aesirkth/Sigurd/Hardware/Sensor.kicad_pcb

## KiCad design Hardware/Sensor.kicad_pcb (2025-11-24)

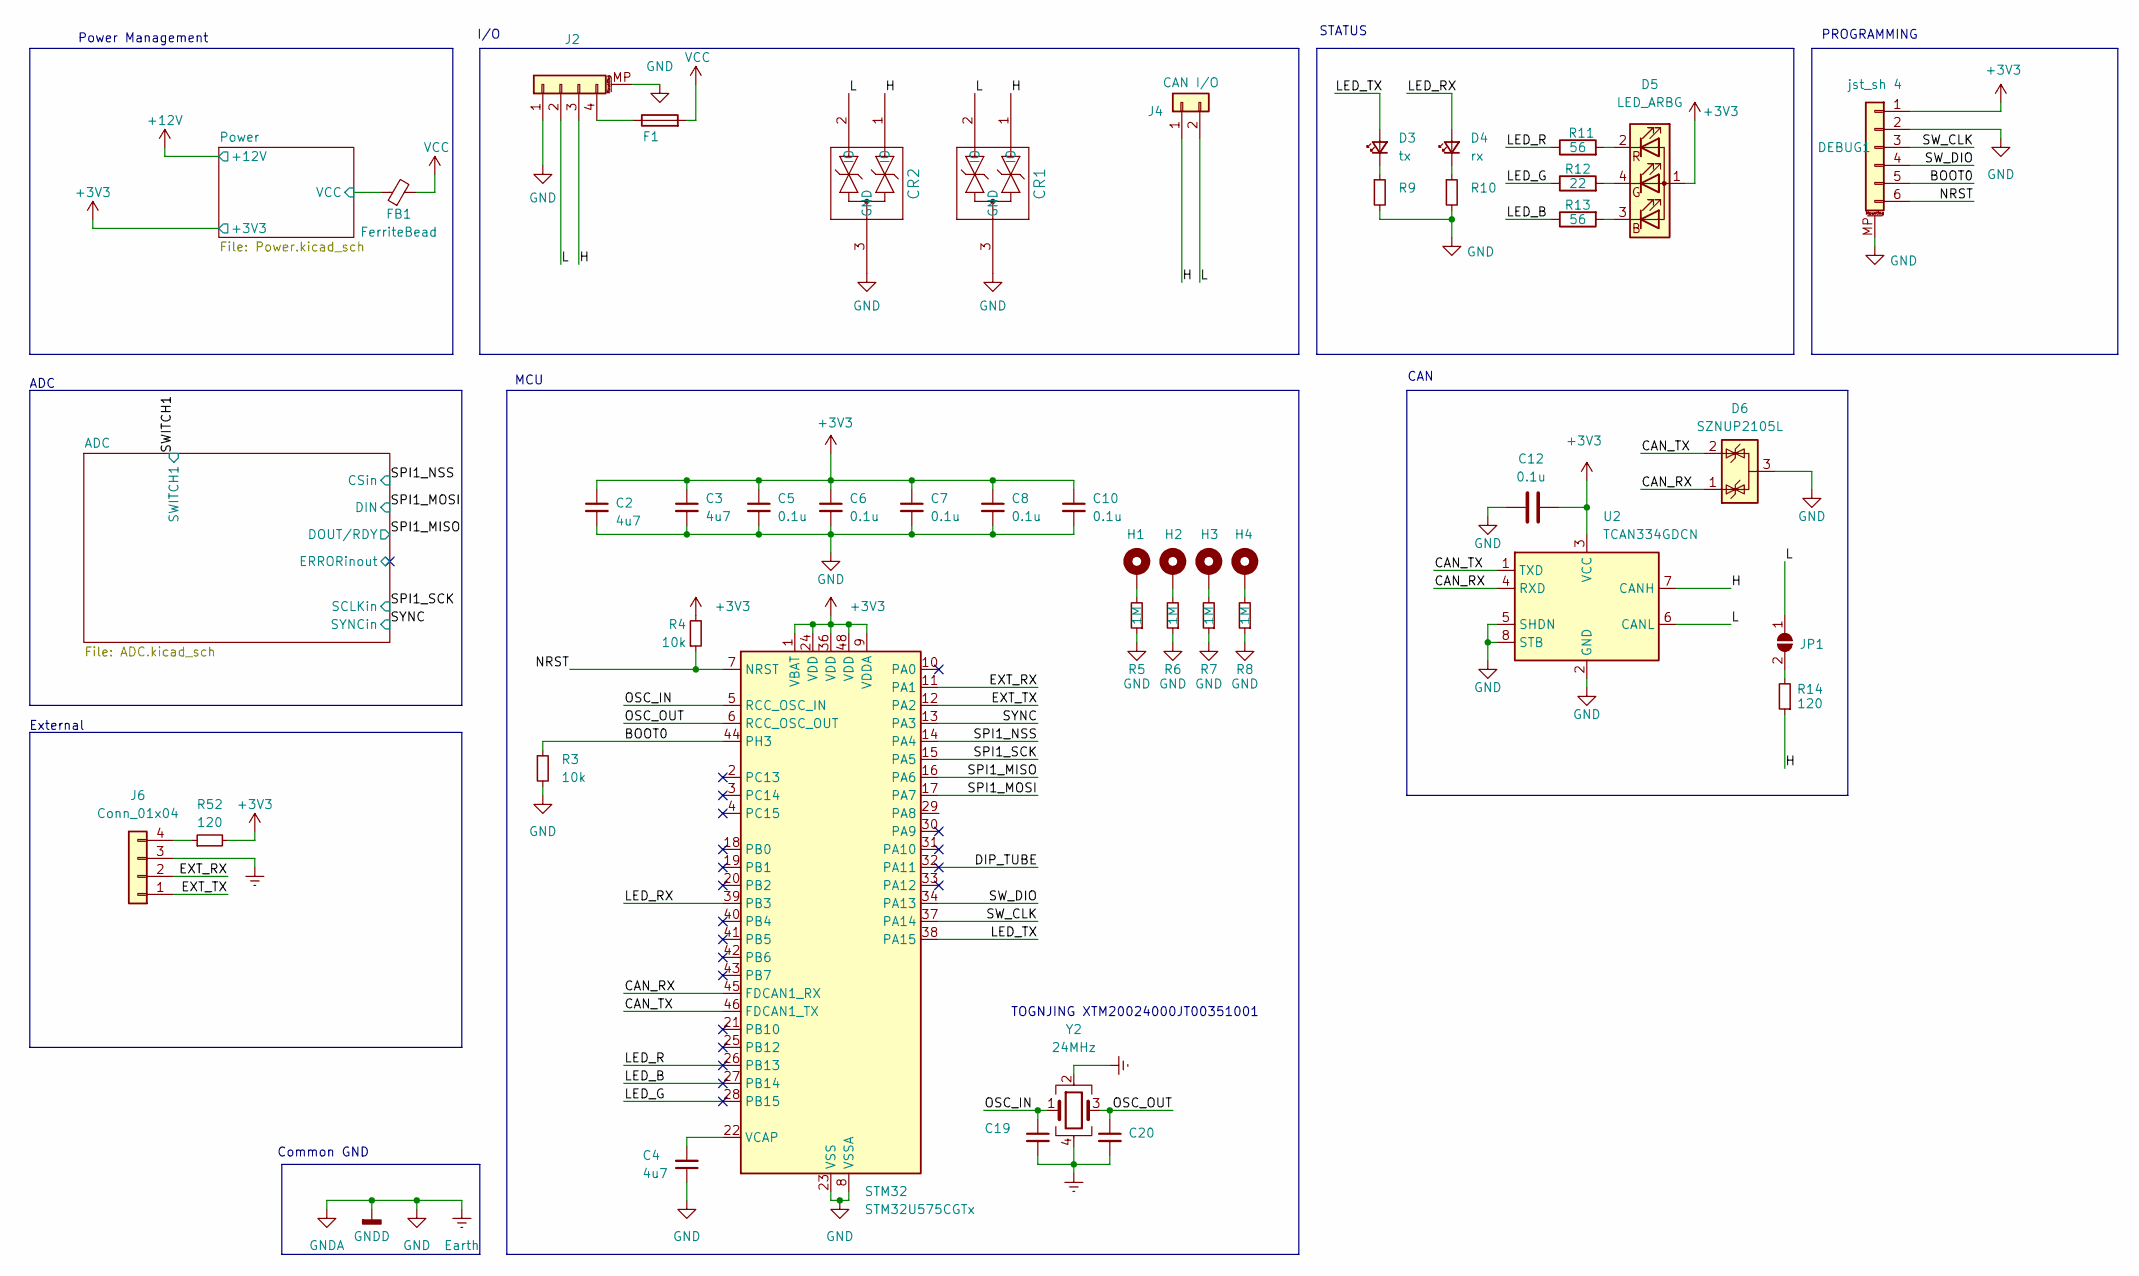
[picture p1: schematic Sensor.kicad_sch]

Parts:
C2, C3, C4: 4u7; C_0402_1005Metric
C5, C6, C7, C8, C10, C12: 0.1u; C_0402_1005Metric
C19, C20: 18p; C_0402_1005Metric
CR1, CR2: ESD2CAN36DBZRQ1; SOT-23-3
D3: tx; LED_0603_1608Metric_Pad1.05x0.95mm_HandSolder
D4: rx; LED_0603_1608Metric_Pad1.05x0.95mm_HandSolder
D5: LED_ARBG; LED_Lumex_SML-LX0404SIUPGUSB
D6: SZNUP2105L; SOT-23
DEBUG1: jst_sh 4; JST_SH_SM06B-SRSS-TB_1x06-1MP_P1.00mm_Horizontal
F1: Fuse_1206_3216Metric
FB1: FerriteBead; L_0603_1608Metric
H1, H2, H3, H4: MountingHole_Pad; MountingHole_3.2mm_M3_Pad_Via
J2: Conn_01x04_MountingPin; JST_GH_BM04B-GHS-TBT_1x04-1MP_P1.25mm_Vertical
J4: CAN I/O; JST_XH_B2B-XH-A_1x02_P2.50mm_Vertical
J6: Conn_01x04; PinSocket_1x04_P1.27mm_Vertical
JP1: SolderJumper_2_Open; SolderJumper-2_P1.3mm_Open_TrianglePad1.0x1.5mm
R3, R4: 10k; R_0402_1005Metric
R5, R6, R7, R8: 1M; R_0603_1608Metric_Pad0.98x0.95mm_HandSolder
R9, R10: 330; R_0603_1608Metric_Pad0.98x0.95mm_HandSolder
R11, R13: 56; R_0603_1608Metric_Pad0.98x0.95mm_HandSolder
R12: 22; R_0603_1608Metric_Pad0.98x0.95mm_HandSolder
R14: 120; R_0603_1608Metric_Pad0.98x0.95mm_HandSolder
R52: 120; R_0402_1005Metric
STM32: STM32U575CGTx; LQFP-48_7x7mm_P0.5mm
U2: TCAN334GDCN; TSOT-23-8
Y2: 24MHz; Crystal_SMD_2016-4Pin_2.0x1.6mm

Connections:
+3V3: C2.1, C3.1, C5.1, C6.1, C7.1, C8.1, C10.1, C12.2, D5.1 (A), DEBUG1.1, R4.2, R52.2, STM32.1 (VBAT), STM32.9 (VDDA), STM32.24 (VDD), STM32.36 (VDD), STM32.48 (VDD), U2.3 (VCC); also elsewhere on the board
+12V: FB1.1; also elsewhere on the board
/BOOT0: DEBUG1.5, R3.1, STM32.44 (PH3)
/CAN_RX: D6.1 (K), STM32.45 (FDCAN1_RX), U2.4 (RXD)
/CAN_TX: D6.2 (K), STM32.46 (FDCAN1_TX), U2.1 (TXD)
/DIP_TUBE: STM32.32 (PA11)
/EXT_RX: J6.2, STM32.11 (PA1)
/EXT_TX: J6.1, STM32.12 (PA2)
/H: CR1.1 (IO), CR2.1 (IO), J2.3, J4.1, R14.1, U2.7 (CANH)
/L: CR1.2 (IO), CR2.2 (IO), J2.2, J4.2, JP1.1 (A), U2.6 (CANL)
/LED_B: R13.1, STM32.27 (PB14)
/LED_G: R12.1, STM32.28 (PB15)
/LED_R: R11.1, STM32.26 (PB13)
/LED_RX: D4.2 (A), STM32.39 (PB3)
/LED_TX: D3.2 (A), STM32.38 (PA15)
/NRST: DEBUG1.6, R4.1, STM32.7 (NRST)
/OSC_IN: C19.1, STM32.5 (RCC_OSC_IN), Y2.1
/OSC_OUT: C20.1, STM32.6 (RCC_OSC_OUT), Y2.3
/SPI1_MISO: STM32.16 (PA6); also elsewhere on the board
/SPI1_MOSI: STM32.17 (PA7); also elsewhere on the board
/SPI1_NSS: STM32.14 (PA4); also elsewhere on the board
/SPI1_SCK: STM32.15 (PA5); also elsewhere on the board
/SW_CLK: DEBUG1.3, STM32.37 (PA14)
/SW_DIO: DEBUG1.4, STM32.34 (PA13)
/SYNC: STM32.13 (PA3); also elsewhere on the board
Earth: C2.2, C3.2, C4.1, C5.2, C6.2, C7.2, C8.2, C10.2, C12.1, C19.2, C20.2, CR1.3 (GND), CR2.3 (GND), D6.3 (A), DEBUG1.2, DEBUG1.MP (MountPin), J2.1, J2.MP (MountPin), J6.3, R3.2, R5.1, R6.1, R7.1, R8.1, R9.2, R10.2, STM32.8 (VSSA), STM32.23 (VSS), STM32.35 (VSS), STM32.47 (VSS), U2.2 (GND), U2.5 (SHDN), U2.8 (STB), Y2.2, Y2.4; also elsewhere on the board
unnamed: D3.1 (K), R9.1
unnamed: D4.1 (K), R10.1
unnamed: D5.3 (BK), R13.2
unnamed: D5.4 (GK), R12.2
unnamed: D5.2 (RK), R11.2
unnamed: H1.1, R5.2
unnamed: H2.1, R6.2
unnamed: H3.1, R7.2
unnamed: H4.1, R8.2
unnamed: F1.1, J2.4
unnamed: J6.4, R52.1
unnamed: JP1.2 (B), R14.2
unnamed: C4.2, STM32.22 (VCAP)
VCC: F1.2, FB1.2

Notes on the sheet:
MCU
PROGRAMMING
External
STATUS
CAN
ADC
I/O
Power Management
Common GND
TOGNJING XTM20024000JT00351001

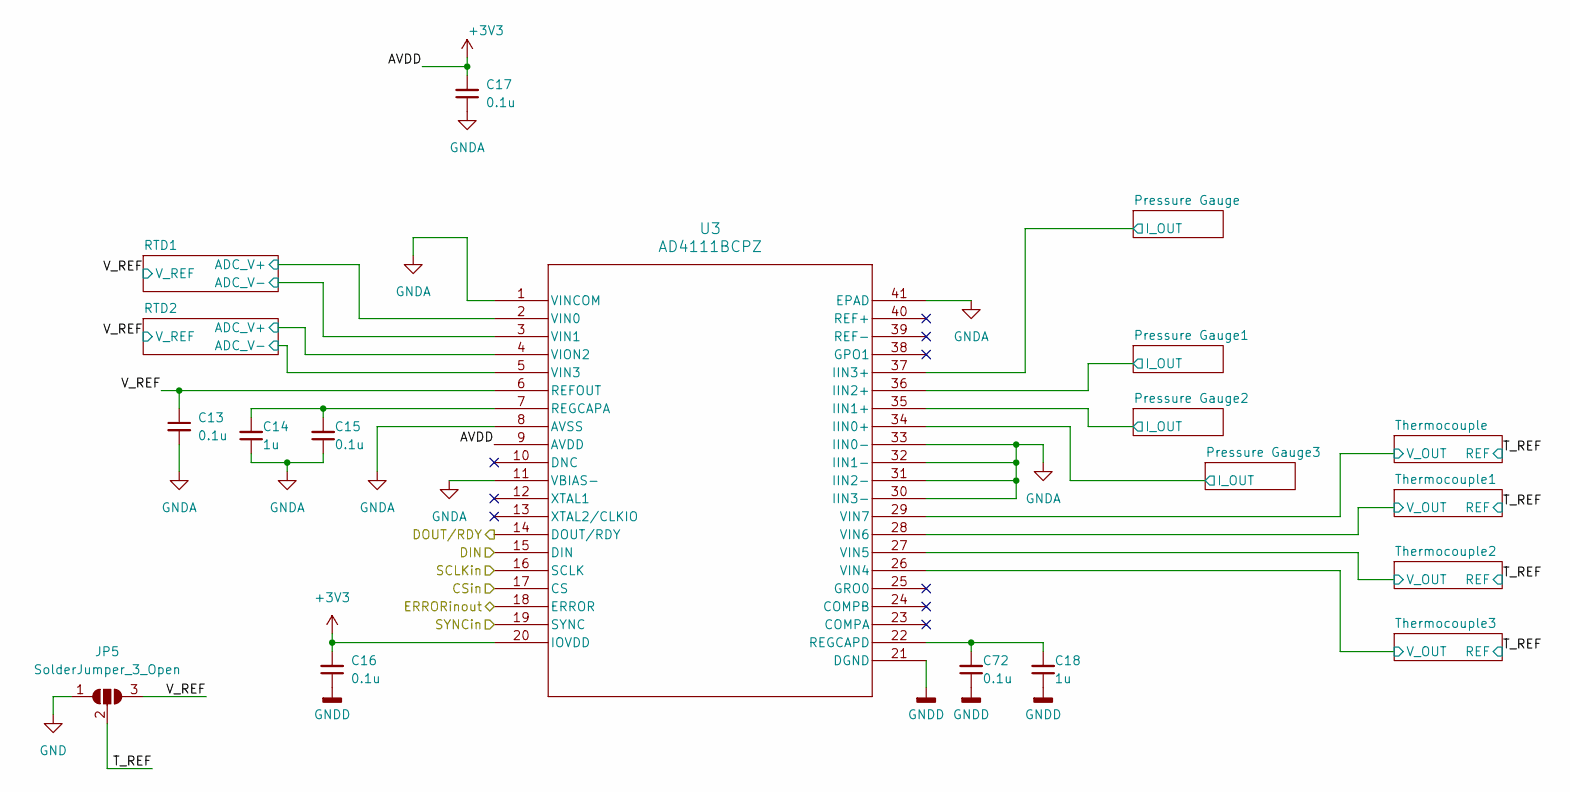
[picture p2: schematic ADC.kicad_sch]

Parts:
C13, C15, C16, C17, C72: 0.1u; C_0402_1005Metric
C14, C18: 1u; C_0402_1005Metric
JP5: SolderJumper_3_Open; SolderJumper-3_P1.3mm_Open_Pad1.0x1.5mm_NumberLabels
U3: AD4111BCPZ; AD4111BCPZ_ADI

Connections:
+3V3: C16.2, C17.2, U3.9 (AVDD), U3.20 (IOVDD); also elsewhere on the board
/ADC/ERRORinout: U3.18 (ERROR)
/ADC/Pressure Gauge1/I_OUT: U3.36 (IIN2+); also elsewhere on the board
/ADC/Pressure Gauge2/I_OUT: U3.35 (IIN1+); also elsewhere on the board
/ADC/Pressure Gauge3/I_OUT: U3.34 (IIN0+); also elsewhere on the board
/ADC/Pressure Gauge/I_OUT: U3.37 (IIN3+); also elsewhere on the board
/ADC/RTD1/ADC_V+: U3.2 (VIN0); also elsewhere on the board
/ADC/RTD1/ADC_V-: U3.3 (VIN1); also elsewhere on the board
/ADC/RTD2/ADC_V+: U3.4 (VION2); also elsewhere on the board
/ADC/RTD2/ADC_V-: U3.5 (VIN3); also elsewhere on the board
/ADC/T_REF: JP5.2 (C); also elsewhere on the board
/ADC/Thermocouple1/V_OUT: U3.28 (VIN6); also elsewhere on the board
/ADC/Thermocouple2/V_OUT: U3.27 (VIN5); also elsewhere on the board
/ADC/Thermocouple3/V_OUT: U3.26 (VIN4); also elsewhere on the board
/ADC/Thermocouple/V_OUT: U3.29 (VIN7); also elsewhere on the board
/ADC/V_REF: C13.1, JP5.3 (B), U3.6 (REFOUT); also elsewhere on the board
/SPI1_MISO: U3.14 (DOUT/RDY); also elsewhere on the board
/SPI1_MOSI: U3.15 (DIN); also elsewhere on the board
/SPI1_NSS: U3.17 (CS); also elsewhere on the board
/SPI1_SCK: U3.16 (SCLK); also elsewhere on the board
/SYNC: U3.19 (SYNC); also elsewhere on the board
Earth: C13.2, C14.1, C15.1, C16.1, C17.1, C18.1, C72.1, JP5.1 (A), U3.1 (VINCOM), U3.8 (AVSS), U3.11 (VBIAS-), U3.21 (DGND), U3.30 (IIN3-), U3.31 (IIN2-), U3.32 (IIN1-), U3.33 (IIN0-), U3.41 (EPAD); also elsewhere on the board
unnamed: C14.2, C15.2, U3.7 (REGCAPA)
unnamed: C18.2, C72.2, U3.22 (REGCAPD)

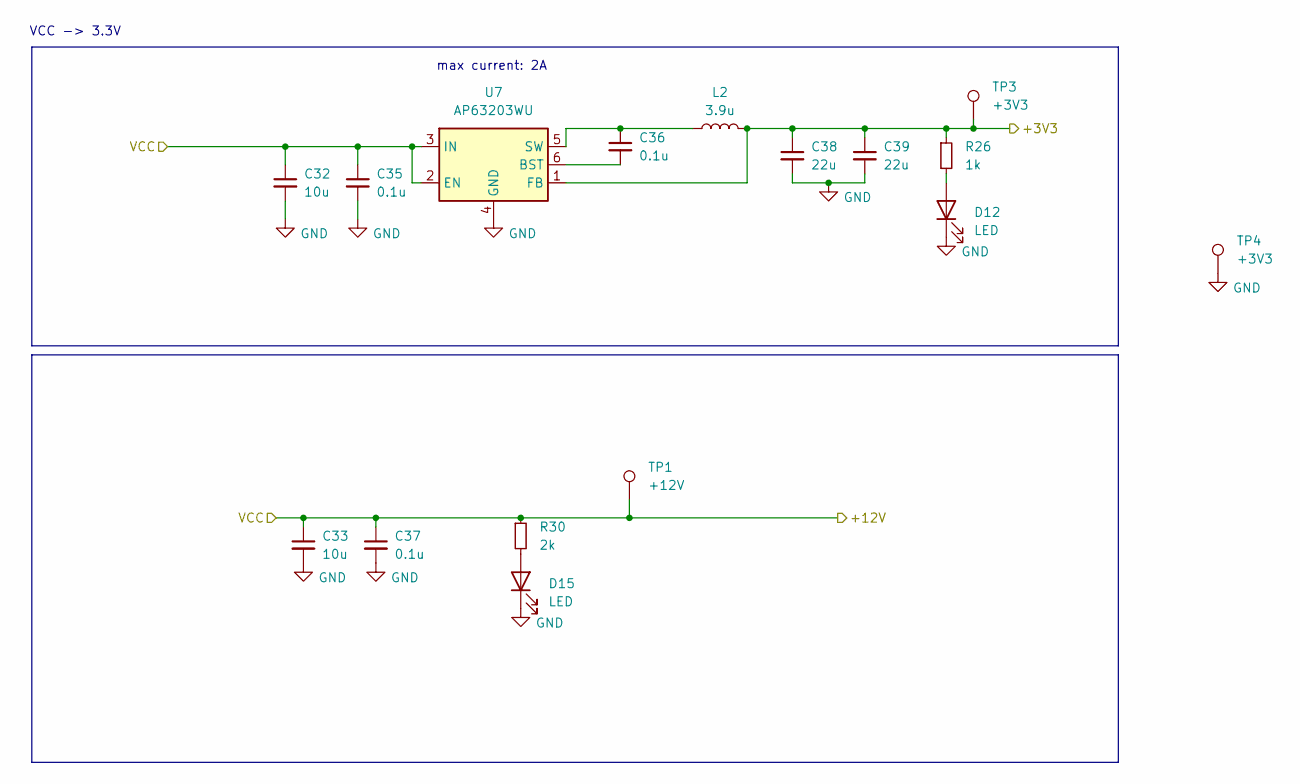
[picture p3: schematic Power.kicad_sch]

Parts:
C32, C33: 10u; C_0603_1608Metric
C35, C36, C37: 0.1u; C_0402_1005Metric
C38, C39: 22u; C_0603_1608Metric
D12, D15: LED; D_0603_1608Metric
L2: 3.9u; L_Changjiang_FNR4030S
R26: 1k; R_0603_1608Metric
R30: 2k; R_0603_1608Metric
TP1: +12V; TestPoint_Pad_D2.0mm
TP3, TP4: +3V3; TestPoint_Pad_D2.0mm
U7: AP63203WU; TSOT-23-6

Connections:
+3V3: C38.1, C39.1, L2.2, R26.1, TP3.1, U7.1 (FB); also elsewhere on the board
+12V: C32.1, C33.1, C35.1, C37.1, R30.1, TP1.1, U7.2 (EN), U7.3 (IN); also elsewhere on the board
Earth: C32.2, C33.2, C35.2, C37.2, C38.2, C39.2, D12.1 (K), D15.1 (K), TP4.1, U7.4 (GND); also elsewhere on the board
unnamed: D12.2 (A), R26.2
unnamed: D15.2 (A), R30.2
unnamed: C36.2, U7.6 (BST)
unnamed: C36.1, L2.1, U7.5 (SW)

Notes on the sheet:
max current: 2A
VCC -> 3.3V

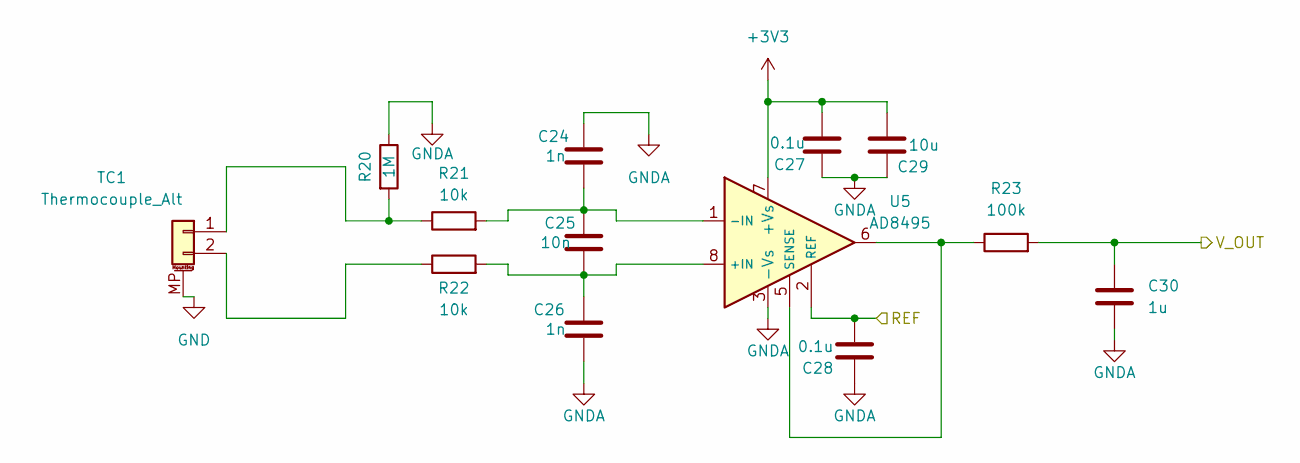
[picture p4: schematic Thermocouple.kicad_sch]

Parts:
C24, C26: 1n; C_0603_1608Metric
C25: 10n; C_0603_1608Metric
C27, C28: 0.1u; C_0402_1005Metric
C29: 10u; C_0603_1608Metric
C30: 1u; C_0402_1005Metric
R20: 1M; R_0402_1005Metric
R21, R22: 10k; R_0402_1005Metric
R23: 100k; R_0402_1005Metric
TC1: Thermocouple_Alt; Molex_Micro-Fit_3.0_43650-0210_1x02-1MP_P3.00mm_Horizontal
U5: AD8495; MSOP-8_3x3mm_P0.65mm

Connections:
+3V3: C27.2, C29.2, U5.7 (+Vs); also elsewhere on the board
/ADC/T_REF: C28.2, U5.2 (REF); also elsewhere on the board
/ADC/Thermocouple/V_OUT: C30.1, R23.2; also elsewhere on the board
Earth: C24.1, C26.2, C27.1, C28.1, C29.1, C30.2, R20.1, TC1.MP (MountPin), U5.3 (-Vs); also elsewhere on the board
unnamed: R20.2, R21.1, TC1.1
unnamed: R22.1, TC1.2
unnamed: C25.2, C26.1, R22.2, U5.8 (+IN)
unnamed: C24.2, C25.1, R21.2, U5.1 (-IN)
unnamed: R23.1, U5.5 (SENSE), U5.6

Parts of its further copies:
C46, C48, C53, C55, C60, C62: 1n; C_0603_1608Metric
C47, C54, C61: 10n; C_0603_1608Metric
C49, C50, C56, C57, C63, C64: 0.1u; C_0402_1005Metric
C51, C58, C65: 10u; C_0603_1608Metric
C52, C59, C66: 1u; C_0402_1005Metric
R31, R35, R39: 1M; R_0402_1005Metric
R32, R33, R36, R37, R40, R41: 10k; R_0402_1005Metric
R34, R38, R42: 100k; R_0402_1005Metric
TC2, TC3, TC4: Thermocouple_Alt; Molex_Micro-Fit_3.0_43650-0210_1x02-1MP_P3.00mm_Horizontal
U9, U10, U11: AD8495; MSOP-8_3x3mm_P0.65mm

Connections of its further copies:
+3V3: C49.2, C51.2, C56.2, C58.2, C63.2, C65.2, U9.7 (+Vs), U10.7 (+Vs), U11.7 (+Vs); also elsewhere on the board
/ADC/T_REF: C50.2, C57.2, C64.2, U9.2 (REF), U10.2 (REF), U11.2 (REF); also elsewhere on the board
/ADC/Thermocouple1/V_OUT: C52.1, R34.2; also elsewhere on the board
/ADC/Thermocouple2/V_OUT: C59.1, R38.2; also elsewhere on the board
/ADC/Thermocouple3/V_OUT: C66.1, R42.2; also elsewhere on the board
Earth: C46.1, C48.2, C49.1, C50.1, C51.1, C52.2, C53.1, C55.2, C56.1, C57.1, C58.1, C59.2, C60.1, C62.2, C63.1, C64.1, C65.1, C66.2, R31.1, R35.1, R39.1, TC2.MP (MountPin), TC3.MP (MountPin), TC4.MP (MountPin), U9.3 (-Vs), U10.3 (-Vs), U11.3 (-Vs); also elsewhere on the board
unnamed: R31.2, R32.1, TC2.1
unnamed: R33.1, TC2.2
unnamed: R35.2, R36.1, TC3.1
unnamed: R37.1, TC3.2
unnamed: R39.2, R40.1, TC4.1
unnamed: R41.1, TC4.2
unnamed: C47.2, C48.1, R33.2, U9.8 (+IN)
unnamed: C46.2, C47.1, R32.2, U9.1 (-IN)
unnamed: R34.1, U9.5 (SENSE), U9.6
unnamed: C54.2, C55.1, R37.2, U10.8 (+IN)
unnamed: C53.2, C54.1, R36.2, U10.1 (-IN)
unnamed: R38.1, U10.5 (SENSE), U10.6
unnamed: C61.2, C62.1, R41.2, U11.8 (+IN)
unnamed: C60.2, C61.1, R40.2, U11.1 (-IN)
unnamed: R42.1, U11.5 (SENSE), U11.6

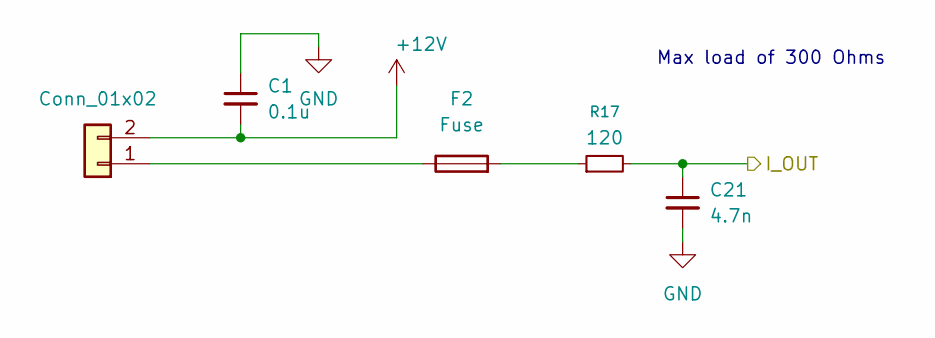
[picture p5: schematic PressureGauge.kicad_sch]

Parts:
C1: 0.1u; C_0603_1608Metric
C21: 4.7n; C_0402_1005Metric
F2: Fuse; Fuse_0603_1608Metric_Pad1.05x0.95mm_HandSolder
J1: Conn_01x02; JST_PH_B2B-PH-K_1x02_P2.00mm_Vertical
R17: 120; R_0402_1005Metric

Connections:
+12V: C1.2, J1.2; also elsewhere on the board
/ADC/Pressure Gauge1/I_OUT: C21.1, R17.2; also elsewhere on the board
Earth: C1.1, C21.2; also elsewhere on the board
unnamed: F2.2, R17.1
unnamed: F2.1, J1.1

Parts of its further copies:
C9, C11, C31: 0.1u; C_0603_1608Metric
C22, C23, C40: 4.7n; C_0402_1005Metric
F4, F6, F8: Fuse; Fuse_0603_1608Metric_Pad1.05x0.95mm_HandSolder
J3, J5, J7: Conn_01x02; JST_PH_B2B-PH-K_1x02_P2.00mm_Vertical
R18, R19, R27: 120; R_0402_1005Metric

Connections of its further copies:
+12V: C9.2, C11.2, C31.2, J3.2, J5.2, J7.2; also elsewhere on the board
/ADC/Pressure Gauge2/I_OUT: C22.1, R18.2; also elsewhere on the board
/ADC/Pressure Gauge3/I_OUT: C23.1, R19.2; also elsewhere on the board
/ADC/Pressure Gauge/I_OUT: C40.1, R27.2; also elsewhere on the board
Earth: C9.1, C11.1, C22.2, C23.2, C31.1, C40.2; also elsewhere on the board
unnamed: F4.2, R18.1
unnamed: F6.2, R19.1
unnamed: F8.2, R27.1
unnamed: F4.1, J3.1
unnamed: F6.1, J5.1
unnamed: F8.1, J7.1

Notes on the sheet:
Max load of 300 Ohms

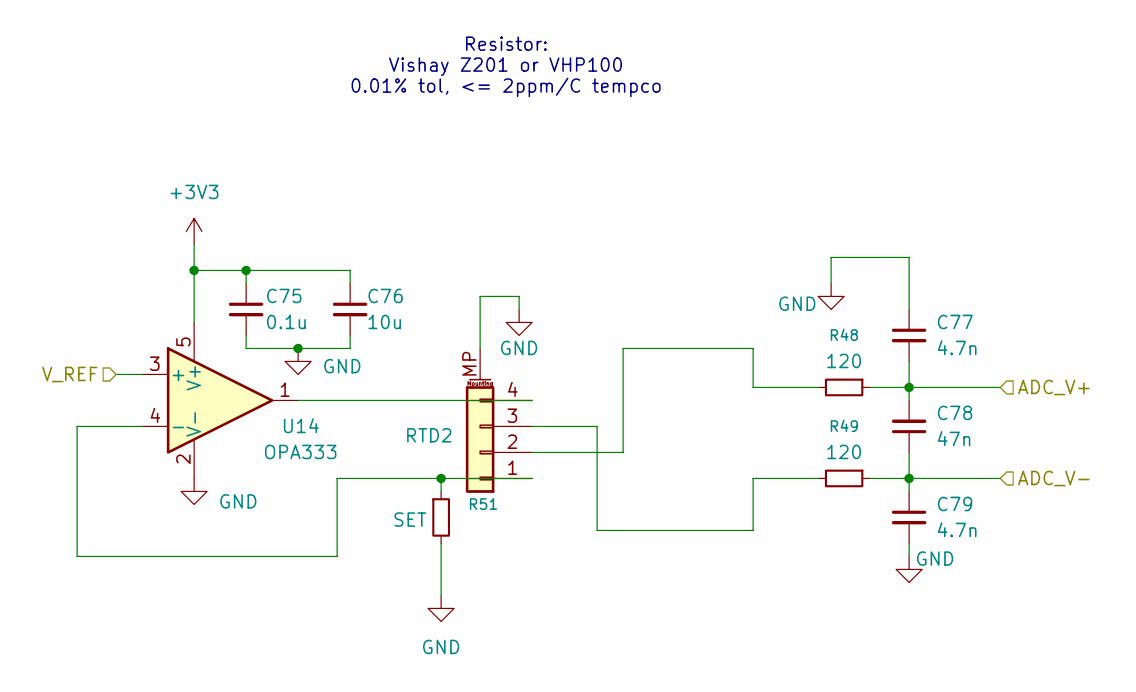
[picture p6: schematic RTD.kicad_sch]

Parts:
C75: 0.1u; C_0402_1005Metric
C76: 10u; C_0603_1608Metric
C77, C79: 4.7n; C_0402_1005Metric
C78: 47n; C_0402_1005Metric
R48, R49: 120; R_0402_1005Metric
R51: SET; R_0603_1608Metric_Pad0.98x0.95mm_HandSolder
RTD2: Conn_01x04_MountingPin; JST_GH_SM04B-GHS-TB_1x04-1MP_P1.25mm_Horizontal
U14: OPA333; SOT-23-5_HandSoldering

Connections:
+3V3: C75.1, C76.1, U14.5 (V+); also elsewhere on the board
/ADC/RTD2/ADC_V+: C77.2, C78.2, R48.1; also elsewhere on the board
/ADC/RTD2/ADC_V-: C78.1, C79.1, R49.1; also elsewhere on the board
/ADC/V_REF: U14.3 (+); also elsewhere on the board
Earth: C75.2, C76.2, C77.1, C79.2, R51.2, RTD2.MP (MountPin), U14.2 (V-); also elsewhere on the board
unnamed: R51.1, RTD2.1, U14.4 (-)
unnamed: R48.2, RTD2.2
unnamed: R49.2, RTD2.3
unnamed: RTD2.4, U14.1

Parts of its further copies:
C67: 0.1u; C_0402_1005Metric
C68: 10u; C_0603_1608Metric
C69, C71: 4.7n; C_0402_1005Metric
C70: 47n; C_0402_1005Metric
R28, R44: 120; R_0402_1005Metric
R50: SET; R_0603_1608Metric_Pad0.98x0.95mm_HandSolder
RTD1: Conn_01x04_MountingPin; JST_GH_SM04B-GHS-TB_1x04-1MP_P1.25mm_Horizontal
U12: OPA333; SOT-23-5_HandSoldering

Connections of its further copies:
+3V3: C67.1, C68.1, U12.5 (V+); also elsewhere on the board
/ADC/RTD1/ADC_V+: C69.2, C70.2, R44.1; also elsewhere on the board
/ADC/RTD1/ADC_V-: C70.1, C71.1, R28.1; also elsewhere on the board
/ADC/V_REF: U12.3 (+); also elsewhere on the board
Earth: C67.2, C68.2, C69.1, C71.2, R50.2, RTD1.MP (MountPin), U12.2 (V-); also elsewhere on the board
unnamed: R50.1, RTD1.1, U12.4 (-)
unnamed: R44.2, RTD1.2
unnamed: R28.2, RTD1.3
unnamed: RTD1.4, U12.1

Notes on the sheet:
Resistor: Vishay Z201 or VHP100 0.01% tol, <= 2ppm/C tempco

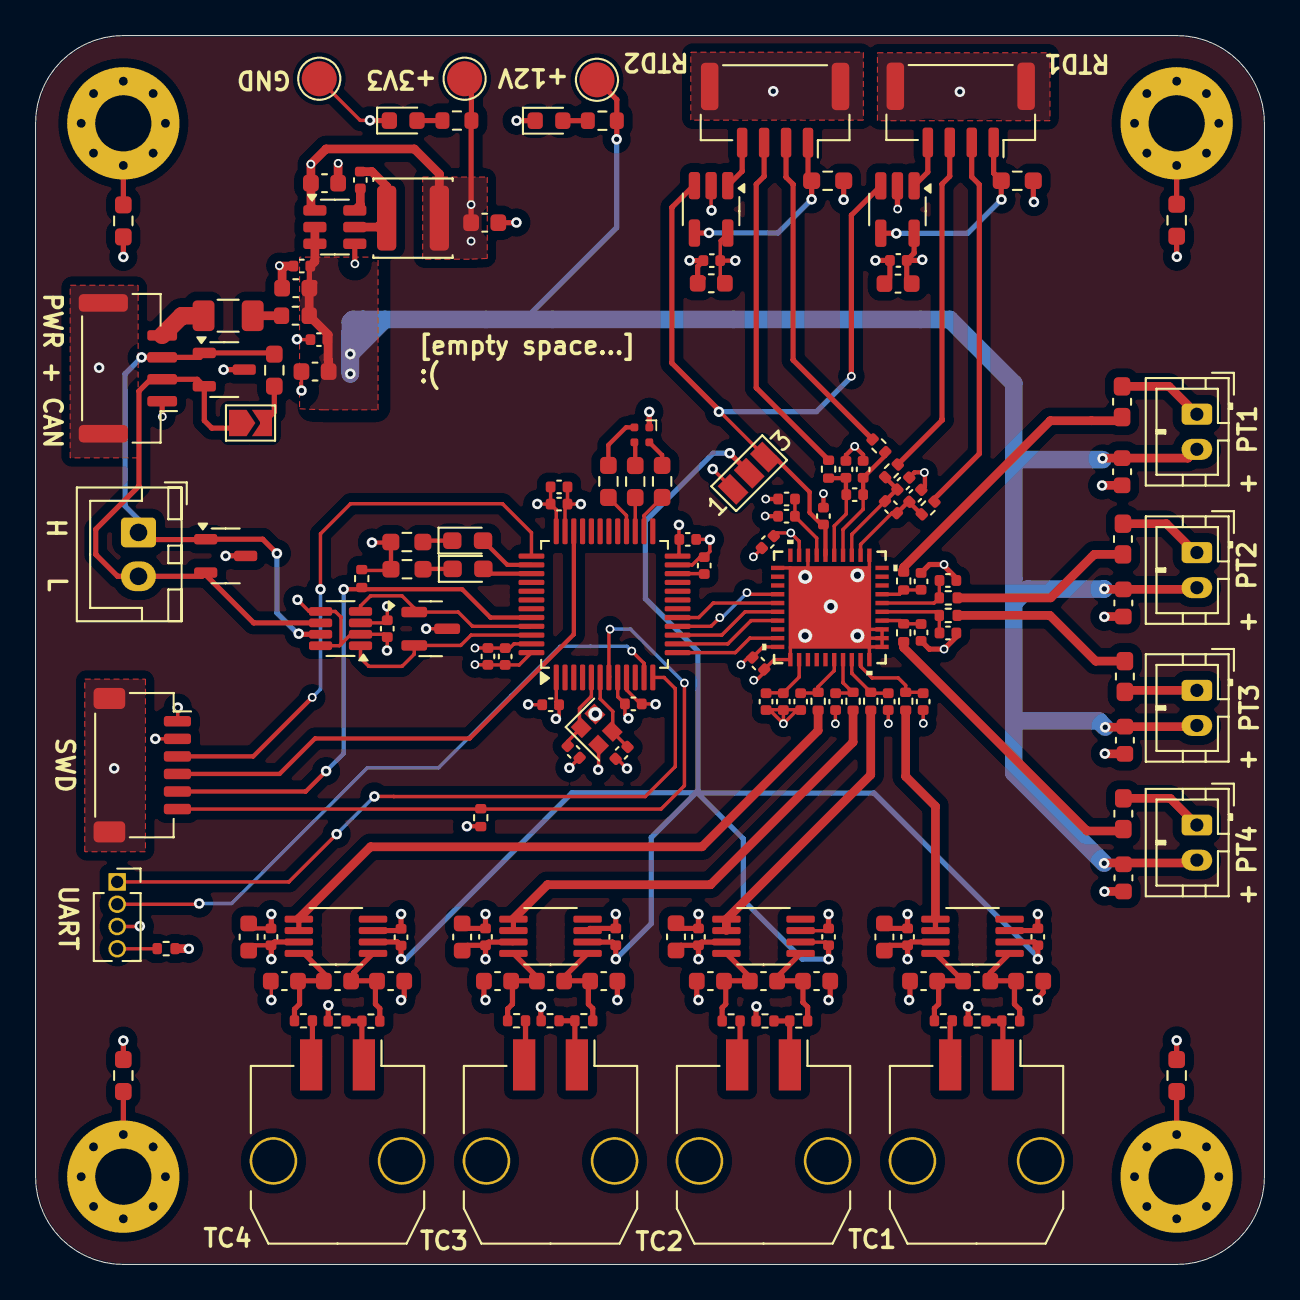
[picture p7: board Sensor.kicad_pcb from above]

Board: 4 copper layers, 70.0 x 70.0 mm, 161 parts (0 on the bottom side), 95 nets.
