aesirkth/Sigurd/Firmware/Core/Src/main.c

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
/* Includes ------------------------------------------------------------------*/
#include "main.h"

/* USER CODE BEGIN Includes */

#include <string.h>
#include "ad717x.h"
#include "ad411x_regs.h"

/* USER CODE END Includes */


SPI_HandleTypeDef hspi1;

/* USER CODE BEGIN PV */

ad717x_dev *adc_dev;

/* USER CODE END PV */

void SystemClock_Config(void);
static void MX_GPIO_Init(void);
static void MX_SPI1_Init(void);
/* USER CODE BEGIN PFP */

extern void ad_build_spi_init(SPI_HandleTypeDef *hspi, GPIO_TypeDef *cs_port, uint16_t cs_pin, struct no_os_spi_init_param *out);
void adc_init(void);

/* USER CODE END PFP */

/**
  * @brief  The application entry point.
  * @retval int
  */
int main(void)
{

  /* MCU Configuration--------------------------------------------------------*/

  /* Reset of all peripherals, Initializes the Flash interface and the Systick. */
  HAL_Init();

  /* Configure the system clock */
  SystemClock_Config();

  /* Initialize all configured peripherals */
  MX_GPIO_Init();
  MX_SPI1_Init();
  /* USER CODE BEGIN 2 */

  adc_init();


  id_val = AD717X_ReadRegister(adc_dev, AD717X_ID_REG);

  /* USER CODE END 2 */

  /* Infinite loop */
  /* USER CODE BEGIN WHILE */
  while (1)
  {

	  int32_t code;

	      if (AD717X_WaitForReady(adc_dev, 1000) == 0 &&
	          ad717x_single_read(adc_dev, 0, &code) == 0)
	      {
	          const float VREF  = 2.5f;
	          const float GAIN  = 1.0f;
	          const float SCALE = VREF / (GAIN * 8388608.0f);

	          float v_adc = (float)code * SCALE; // volts at ADC pin

	          // AD8495 amp (5 mV/C)
	          const float MV_PER_C = 0.005f;
	          float tC = v_adc / MV_PER_C;

	          (void)tC;
	      }

    /* USER CODE END WHILE */

    /* USER CODE BEGIN 3 */
  }
  /* USER CODE END 3 */
}

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
/* USER CODE BEGIN 4 */

void adc_init(void)
{
    struct no_os_spi_init_param spi_init;
    ad_build_spi_init(&hspi1, GPIOA, GPIO_PIN_4, &spi_init);

    extern ad717x_st_reg ad4111_regs[];
    size_t num_regs = sizeof(ad4111_regs) / sizeof(ad4111_regs[0]);

    //one channel ; VIN0 vs VINCOM on Setup0
    struct ad717x_channel_map chan_map[1] = {0};
    chan_map[0].analog_inputs.analog_input_pairs = VIN0_VINCOM;
    chan_map[0].setup_sel      = 0;
    chan_map[0].channel_enable = true;

    //Setup0 : bipolar, input/ref buffers enabled, internal ref
    struct ad717x_channel_setup setups[1] = {0};
    setups[0].bi_unipolar = false;    // 1 = bipolar coding
    setups[0].input_buff  = true;
    setups[0].ref_buff    = true;
    setups[0].ref_source  = INTERNAL_REF;

    // filter : sinc5/sinc1, 200 sps
    struct ad717x_filtcon filt[1] = {0};
    filt[0].oder = sinc5_sinc1;
    filt[0].odr  = sps_200;

    ad717x_init_param init = {0};
    init.spi_init       = spi_init;
    init.regs           = ad4111_regs;
    init.num_regs       = (uint8_t)num_regs;
    init.active_device  = ID_AD4111;
    init.ref_en         = true;
    init.num_channels   = 1;
    init.num_setups     = 1;
    init.mode           = SINGLE;

    memcpy(init.chan_map, chan_map, sizeof(chan_map));
    memcpy(init.setups, setups, sizeof(setups));
    memcpy(init.filter_configuration, filt, sizeof(filt));


    if (AD717X_Init(&adc_dev, init) != 0 || adc_dev == NULL) {
        Error_Handler();
    } else {
        ad717x_set_channel_status(adc_dev, 0, true);
    }

}

/* USER CODE END 4 */
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
