aesirkth/Sigurd/Firmware/SensorBoard.ioc

Mcu.UserName=STM32U575CGTx
PA10.Signal=GPIO_Output
PA4.Signal=GPIO_Output
PA5.Signal=SPI1_SCK
PA6.Signal=SPI1_MISO
PA7.Signal=SPI1_MOSI
PA8.Signal=GPIO_Output
PA9.Signal=GPIO_Output
PB12.Signal=GPIO_Output
PB5.Signal=GPIO_Output
