aesirkth/Sigurd/zephyr-firmware/sigurd/app/modules/ad4111/src/no_os_spi_impl.c

/***************************************************************************//**
 *   @file   generic/generic_spi.c
 *   @author DBogdan (dragos.bogdan@analog.com)
********************************************************************************
 * Copyright 2019(c) Analog Devices, Inc.
 *
 * All rights reserved.
 *
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
 * THIS SOFTWARE IS PROVIDED BY ANALOG DEVICES "AS IS" AND ANY EXPRESS OR
 * IMPLIED WARRANTIES, INCLUDING, BUT NOT LIMITED TO, NON-INFRINGEMENT,
 * MERCHANTABILITY AND FITNESS FOR A PARTICULAR PURPOSE ARE DISCLAIMED.
 * IN NO EVENT SHALL ANALOG DEVICES BE LIABLE FOR ANY DIRECT, INDIRECT,
 * INCIDENTAL, SPECIAL, EXEMPLARY, OR CONSEQUENTIAL DAMAGES (INCLUDING, BUT NOT
 * LIMITED TO, INTELLECTUAL PROPERTY RIGHTS, PROCUREMENT OF SUBSTITUTE GOODS OR
 * SERVICES; LOSS OF USE, DATA, OR PROFITS; OR BUSINESS INTERRUPTION) HOWEVER
 * CAUSED AND ON ANY THEORY OF LIABILITY, WHETHER IN CONTRACT, STRICT LIABILITY,
 * OR TORT (INCLUDING NEGLIGENCE OR OTHERWISE) ARISING IN ANY WAY OUT OF THE USE
 * OF THIS SOFTWARE, EVEN IF ADVISED OF THE POSSIBILITY OF SUCH DAMAGE.
*******************************************************************************/

/******************************************************************************/
/***************************** Include Files **********************************/
/******************************************************************************/

#include "no_os/no_os_spi.h"
#include "no_os/no_os_util.h"
#include "ad4111.h"
#include "ad4111_driver.h"

#include <zephyr/drivers/spi.h>
#include <zephyr/logging/log.h>

LOG_MODULE_REGISTER(ad4111_spi, CONFIG_SENSOR_LOG_LEVEL);

/******************************************************************************/
/************************ Functions Definitions *******************************/
/******************************************************************************/

/**
 * @brief Initialize the SPI communication peripheral.
 * @param desc - The SPI descriptor.
 * @param param - The structure that contains the SPI parameters.
 * @return 0 in case of success, -1 otherwise.
 */
int32_t no_os_spi_init(struct no_os_spi_desc **desc,
			 const struct no_os_spi_init_param *param)
{
	struct no_os_spi_desc *spi_desc = malloc(sizeof(struct no_os_spi_desc));
	spi_desc->extra = param->extra;
	*desc = spi_desc;
	return 0;
}

/**
 * @brief Free the resources allocated by no_os_spi_init().
 * @param desc - The SPI descriptor.
 * @return 0 in case of success, -1 otherwise.
 */
int32_t no_os_spi_remove(struct no_os_spi_desc *desc)
{
	free(desc);
	return 0;
}

/**
 * @brief Write and read data to/from SPI.
 * @param desc - The SPI descriptor.
 * @param data - The buffer with the transmitted/received data.
 * @param bytes_number - Number of bytes to write/read.
 * @return 0 in case of success, -1 otherwise.
 */
int32_t no_os_spi_write_and_read(struct no_os_spi_desc *desc,
				   uint8_t *data,
				   uint16_t bytes_number)
{
	NO_OS_UNUSED_PARAM(desc);
	NO_OS_UNUSED_PARAM(data);
	NO_OS_UNUSED_PARAM(bytes_number);
	const struct device *dev = desc->extra;
	const struct ad4111_config *conf = dev->config;


	uint8_t tx_buf[bytes_number];
    struct spi_buf spi_tx_buf = {
        .buf = tx_buf,
        .len = bytes_number
    };
    struct spi_buf_set spi_tx_buf_set = {
        .buffers = &spi_tx_buf,
        .count = 1
    };

	uint8_t rx_buf[bytes_number];
    struct spi_buf spi_rx_buf = {
        .buf = rx_buf,
        .len = bytes_number
    };
    struct spi_buf_set spi_rx_buf_set = {
        .buffers = &spi_rx_buf,
        .count = 1
    };

	memcpy(tx_buf, data, bytes_number);
	int e = spi_transceive_dt(&conf->spi, &spi_tx_buf_set, &spi_rx_buf_set);
	memcpy(data, rx_buf, bytes_number);

	if (e) {
		return -1;
	}
	return 0;
}
