aesirkth/Sigurd/(commit log)

2025-10-11 added hardware folder
    [ADC.kicad_sch, Power.kicad_sch, PressureGauge.kicad_sch, RTD.kicad_sch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]
2025-11-24 sigurd redesign :)
    [ADC.kicad_sch, Power.kicad_sch, PressureGauge.kicad_sch, RTD.kicad_sch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]
2025-11-24 pushed wrong hardware revision
    [ADC.kicad_sch, BOM-Sensor.csv, Power.kicad_sch, PressureGauge.kicad_sch, RTD.kicad_sch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]
2025-12-10 reading something from ADC but possibly not correct values
    [ad4111.c, main.c, sensors.c, sensors.h]
2025-12-16 added spi.c setup for ADC driver
2025-12-16 spi test
2026-01-21 spi testing things
2026-01-21 spi read register now works
2026-01-22 sigurd can now read spi from ADC
2026-01-27 hardcoded a pseudo-adc driver
2026-01-28 MISO interrupt now works
2026-02-04 interrupt and reading valid data with integer flag
2026-02-04 reading valid data with interrupt and semaphore
